1epaltrik/INFOBOT/robot.png

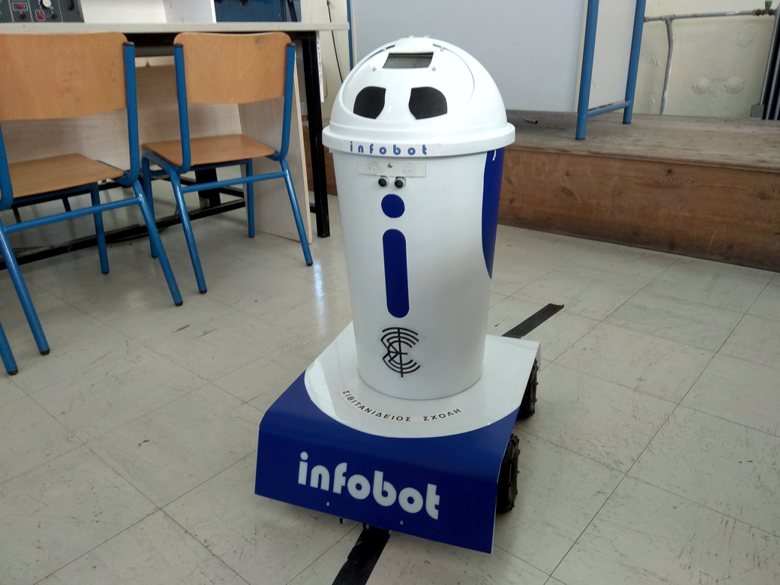
robot.png
