1epaltrik/INFOBOT/Kefalaio_8/ΚΕΦΑΛΑΙΟ_8_ΚΑΤΑΣΚΕΥΗ ΚΑΙ ΚΑΛΩΔΙΩΣΗ ΕΠΑΝΩ ΜΕΡΟΥΣ.docx

ΚΕΦΑΛΑΙΟ 8ο - ΚΑΤΑΣΚΕΥΗ ΕΠΑΝΩ ΜΕΡΟΥΣ

Υλικά:

Α/Α | Περιγραφή | Ποσότητα
1 | 3.5inch_TFT_Touch_Shield | 1
2 | MP3 Player BY-8001-16P | 1
3 | Arduino Atmega | 1
4 | DHT22/AM2302 Digital Temperature And Humidity Sensor | 1
5 | DS3231 Real Time Clock Module | 1
6 | Ηχεία (2 τεμ) | 1
7 | Ultrasonic sensor for arduino | 1

Άνοιγμα οπών για τοποθέτηση των πλακετών.

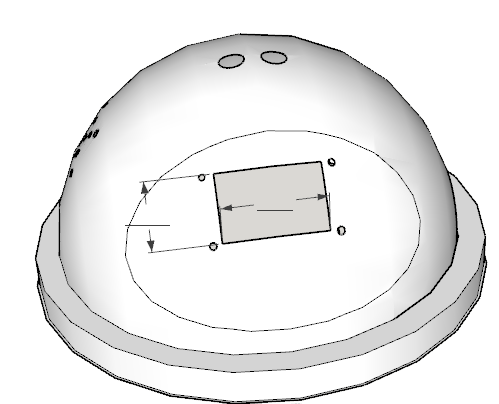
[picture p2: figure]
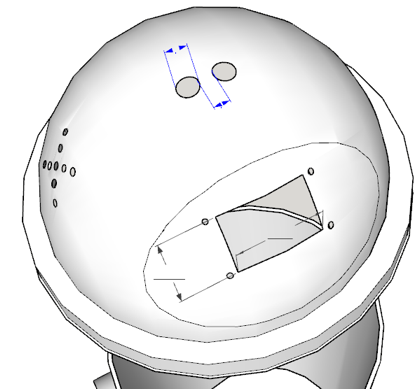
[picture p3: figure]
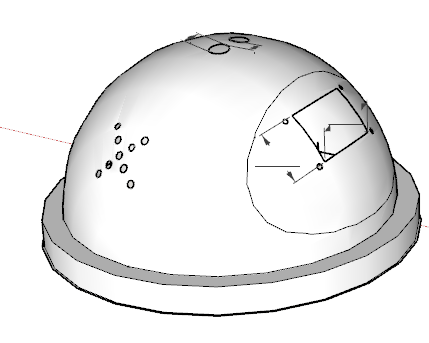
[picture p4: figure]
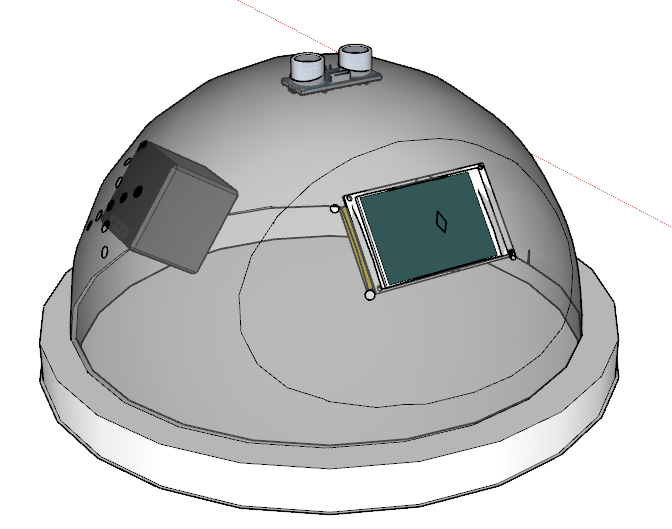
[picture p5: figure]

ΚΑΛΩΔΙΩΣΗ ΕΠΑΝΩ ΜΕΡΟΥΣ

Ακροδέκτες πλακετών.

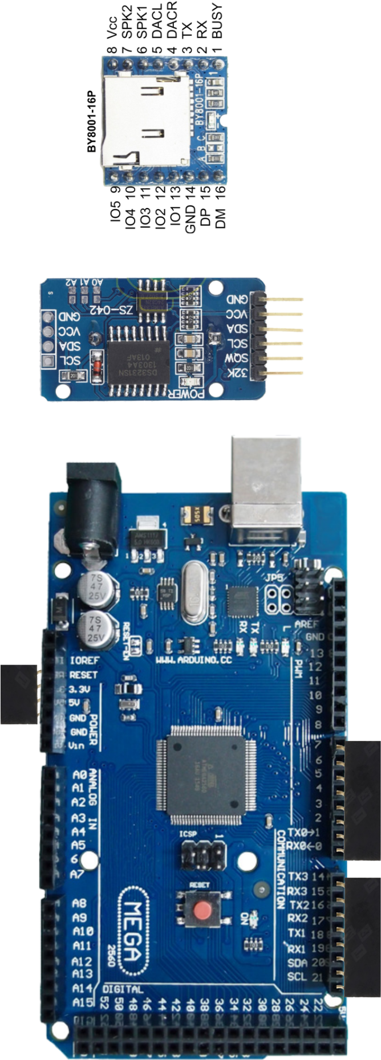
[picture p6: figure]
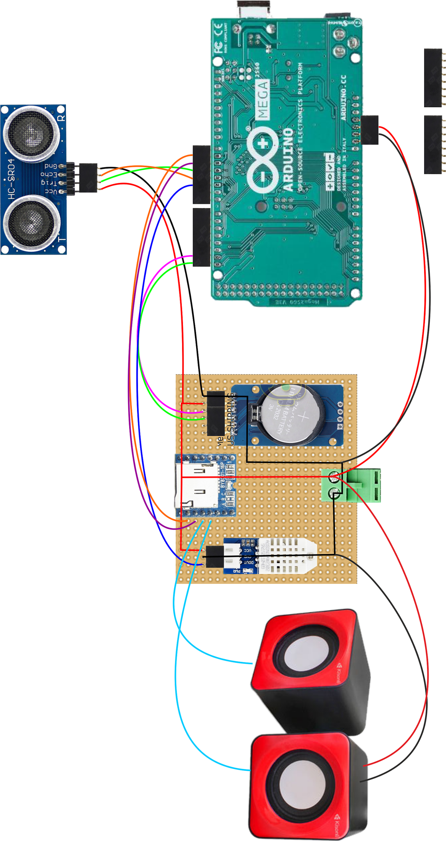
[picture p7: figure]
