1epaltrik/INFOBOT/Kefalaio_7/7ο ΚΕΦΑΛΑΙΟ_ΚΑΛΩΔΙΩΣΕΙΣ ARDUINO.docx

ΚΕΦΑΛΑΙΟ 7ο - ΚΑΛΩΔΙΩΣΕΙΣ ΣΤΟ ARDUINO

Καλωδίωση IR Module στο Arduino

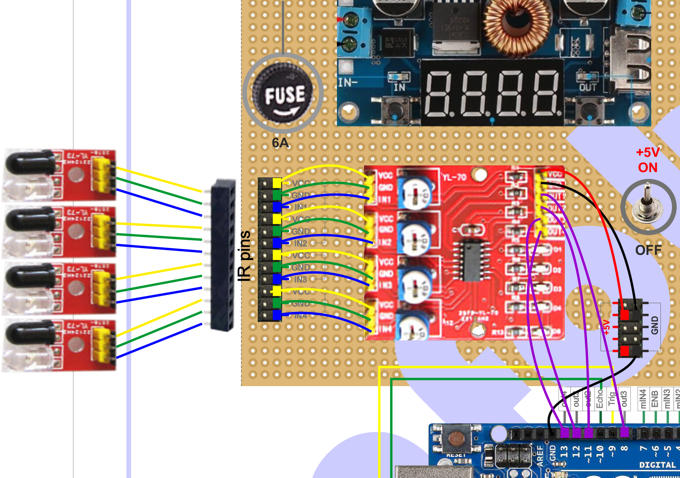
[picture p8: figure]

Καλωδίωση RGB driver Module στο Arduino

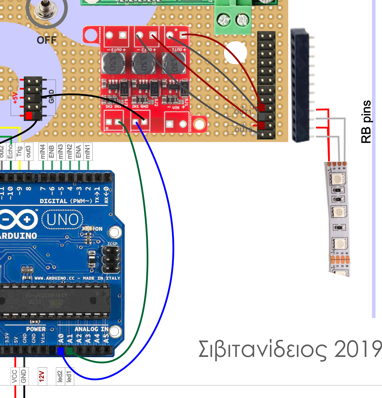
[picture p9: figure]

Καλωδίωση Motor driver Module στο Arduino

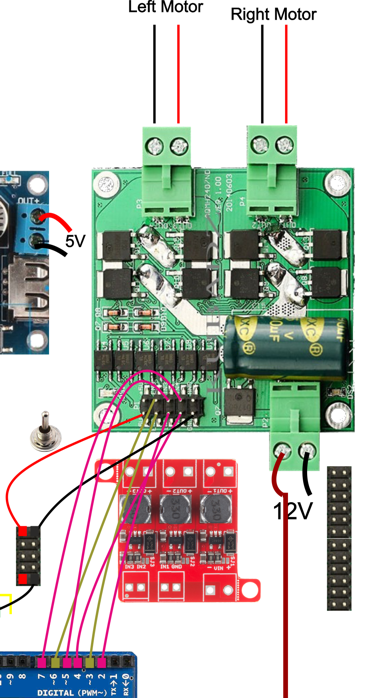
[picture p10: figure]

Σύνδεση UltraSonic και τροφοδοσία στο Arduino

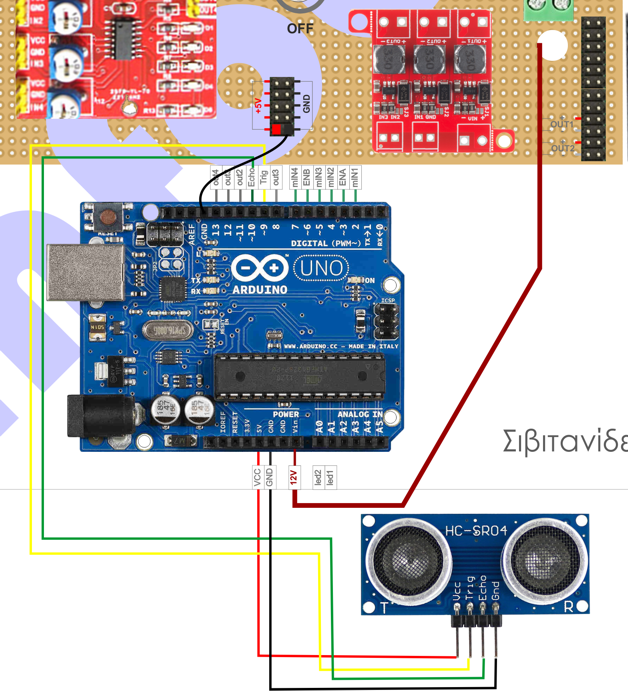
[picture p11: figure]
