1epaltrik/INFOBOT/Kefalaio_5/ΚΕΦΑΛΑΙΟ_5ο_ΟΠΕΣ ΚΑΙ ΚΑΛΩΔΙΩΣΗ ΤΡΟΦΟΔΟΣΙΑΣ.docx

ΚΕΦΑΛΑΙΟ 5ο - ΟΠΕΣ ΠΙΣΩ ΜΕΡΟΥΣ ΚΑΔΟΥ.

Υλικά:

Α/Α | Περιγραφή | Ποσότητα
1 | Επαναφορτιζόμενη μπαταρια μολυβδου 12V 7Ah | 1
2 | Φορτιστης μπαταριων μολυβδου 6-12V | 1
3 | Plug Jack 6,3 Male stereo | 1
4 | Socket, Jack 6,35mm, female, stereo, straight, panel mounting | 1
5 | Διακόπτης ON-OFF 220V | 1

Άνοιγμα οπών για τοποθέτηση θηλυκού βύσματος/διακόπτη φόρτισης μπαταρίας και διακόπτη λειτουργίας, στην πίσω πλευρά του κάδου.

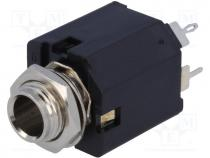
[picture p12: figure]
Socket, Jack 6,35mm, female, stereo, with on/off switch, straight
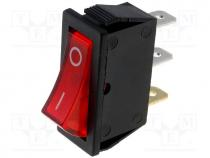
[picture p13: figure]
ROCKER, 2-position, SPST, ON-OFF, 15A/250VAC, red, neon lamp, 35mΩ
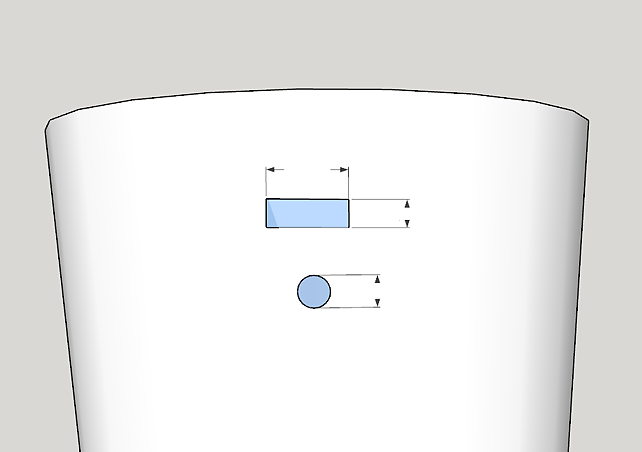
[picture p14: figure]
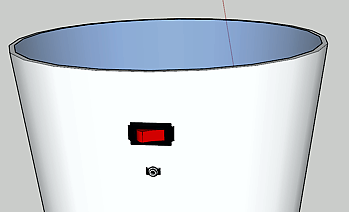
[picture p15: figure]

ΟΠΕΣ ΕΜΠΡΟΣ ΜΕΡΟΥΣ ΚΑΔΟΥ.

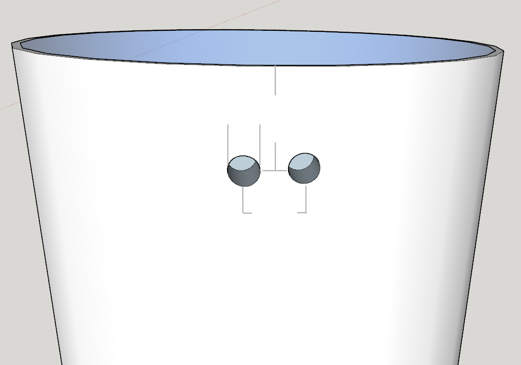
[picture p16: figure]

Τοποθέτηση UltaraSonic HC-SR04

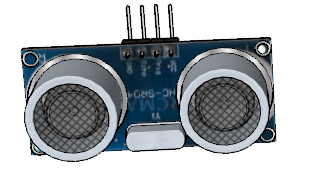
[picture p17: figure]
ultson

ΚΑΛΩΔΙΩΣΗ ΚΥΡΙΑΣ ΤΡΟΦΟΔΟΣΙΑΣ

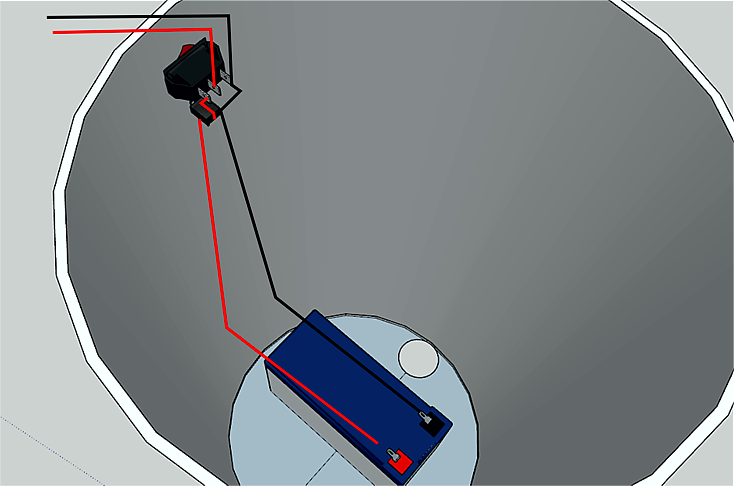
[picture p18: figure]
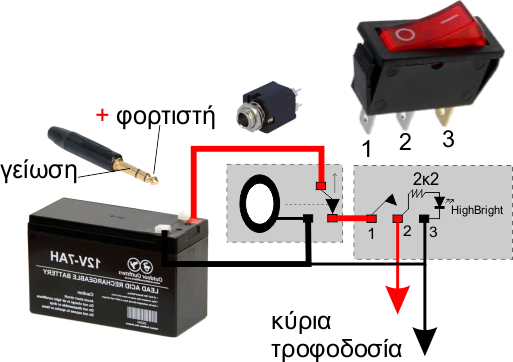
[picture p19: figure]
