1epaltrik/INFOBOT/Kefalaio_6/ΚΕΦΑΛΑΙΟ_6ο_ΚΕΝΤΡΙΚΗ ΠΛΑΚΕΤΑ.docx

6 - ΚΕΝΤΡΙΚΗ ΠΛΑΚΕΤΑ

Υλικά:

Α/Α | Περιγραφή | Ποσότητα
1 | 2x7A DC Motor Driver | 1
2 | 4 IR sensor | 1
3 | Arduino Uno + Shield | 1
4 | LED Driver | 1
5 | Adjustable 5A DC-DC Power Step-down Charge Module | 1
6 | Led strip 5050 | 1m

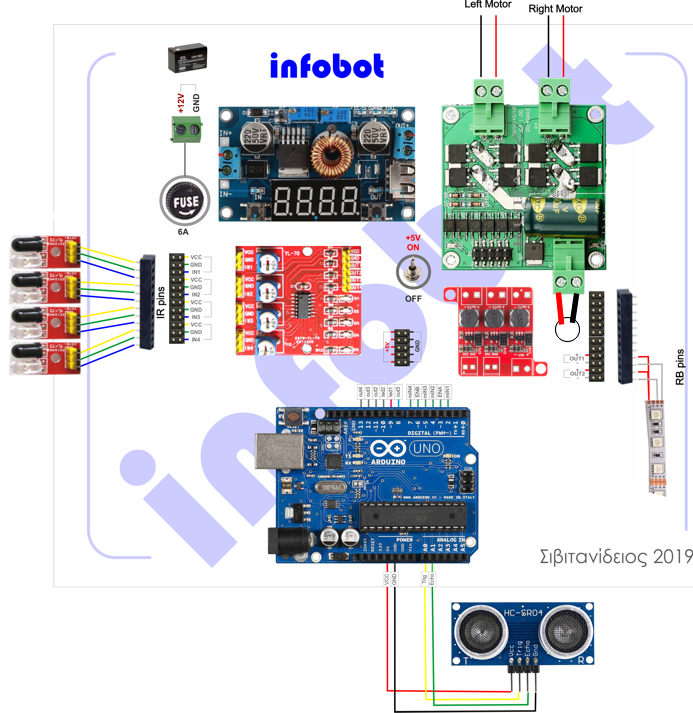
[picture p20: figure]

Πίσω όψη πλακέτας

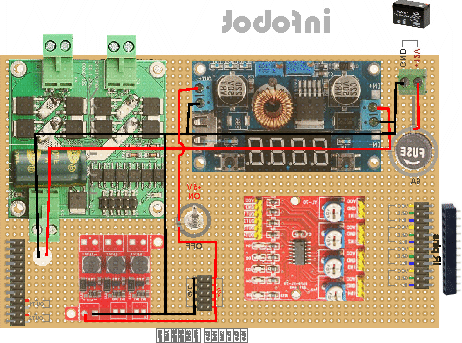
[picture p21: figure]

11 - ΤΟΠΟΘΕΤΗΣΗ ΤΩΝ RGB LED STRIP

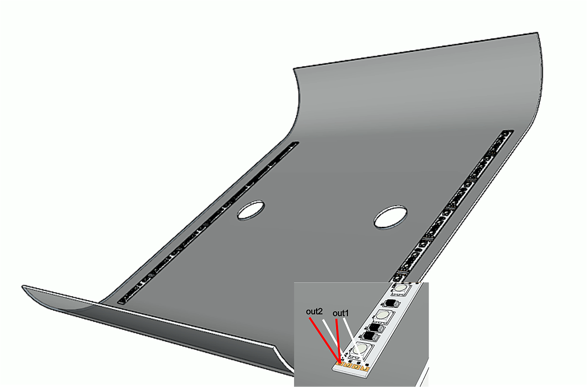
[picture p22: figure]
