1epaltrik/INFOBOT/Kefalaio_3/ΚΕΦΑΛΑΙΟ_3ο_ΒΑΣΗ.docx

ΚΕΦΑΛΑΙΟ 3ο - ΒΑΣΗ

Υλικά:

Α/Α | Περιγραφή | Ποσότητα
1 | Βάση από Plexiglass ή PVC (70x45cm) | 1
2 | Κάδος Αποριμμάτων (60x30x25cm) | 1
3 | Βάση για IR sensors από plexiglass (18x4cm) | 1

PVC ή Plexiglass

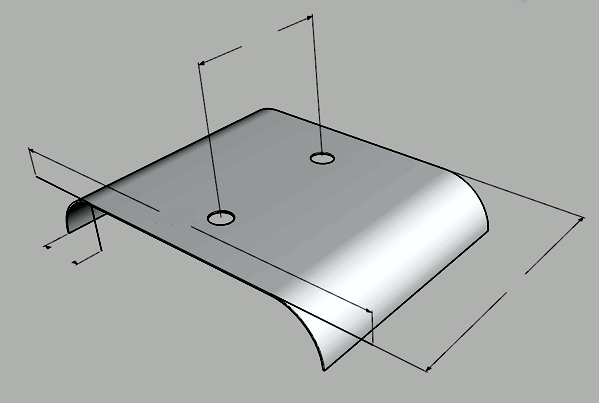
[picture p23: figure]
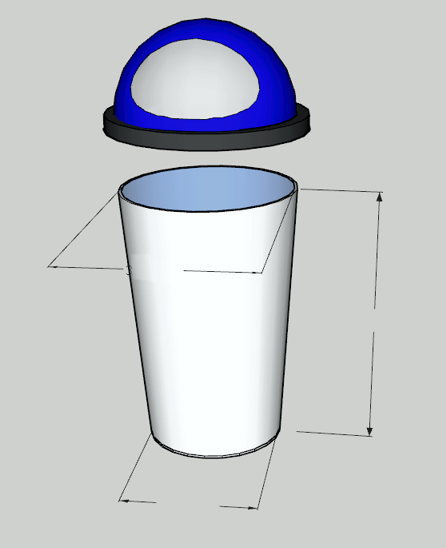
[picture p24: figure]

Κάδος πλαστικός με οπές ώστε να εφαρμόζει ο κάθετος σωλήνας του σκελετού

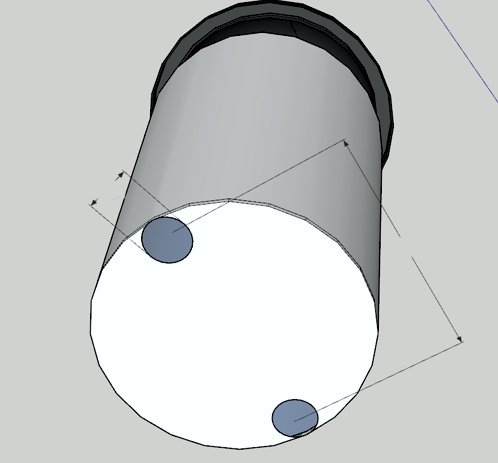
[picture p25: figure]

ΒΑΣΗ ΣΤΗΡΙΞΗΣ IR SENSORS.

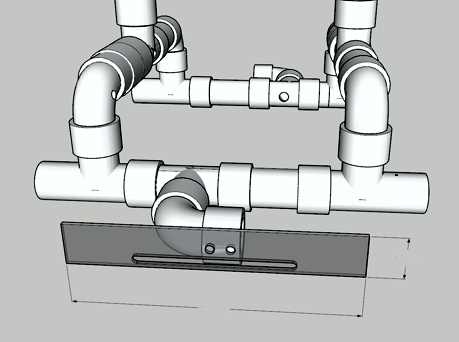
[picture p26: figure]

ΔΗΜΙΟΥΡΓΙΑ ΟΠΩΝ ΚΑΛΩΔΙΩΣΗΣ.

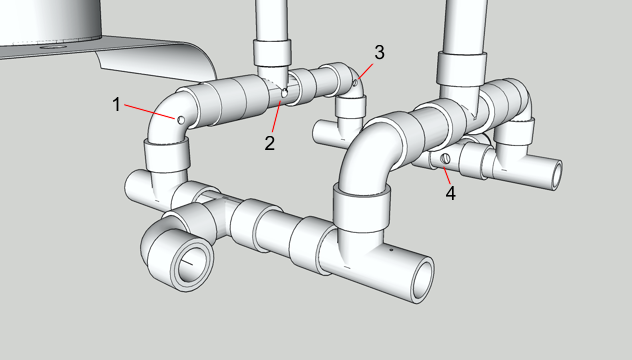
[picture p27: figure]

Χ 2 ΠΛΕΥΡΕΣ

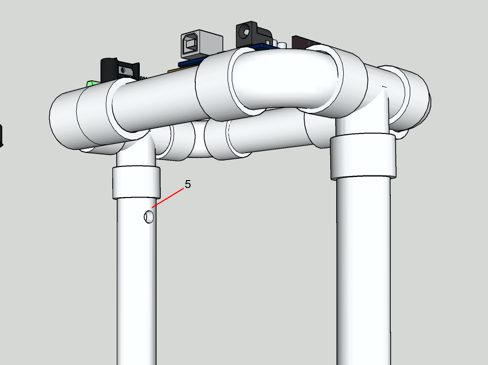
[picture p28: figure]

Χ 2 ΠΛΕΥΡΕΣ
