1epaltrik/INFOBOT/Kefalaio_4/ΚΕΦΑΛΑΙΟ_4ο_ΚΑΛΩΔΙΩΣΗ ΚΑΤΩ ΜΕΡΟΥΣ.docx

ΚΕΦΑΛΑΙΟ 4ο - ΚΑΛΩΔΙΩΣΗ ΚΑΤΩ ΜΕΡΟΥΣ

Υλικά:

Α/Α | Περιγραφή | Ποσότητα
1 | Καλώδιο πολύκλωνο 10 χρώματα
2 | Ακιδοσειρά male | 50 pins
3 | Terminal block | 2

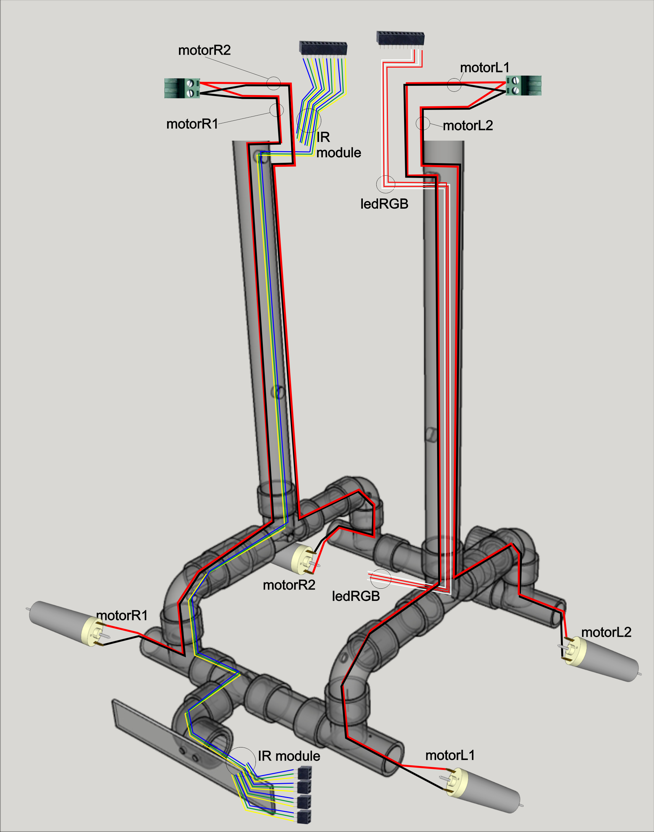
[picture p33: figure]
