1epaltrik/INFOBOT/Kefalaio_2/ΚΕΦΑΛΑΙΟ_2ο_ΣΚΕΛΕΤΟΣ.docx

ΚΕΦΑΛΑΙΟ 2ο - ΣΚΕΛΕΤΟΣ

Υλικά:

Σωλήνες υλικό κατασκευής:

ΤΑΦ διάμετρος Φ: 30 | Γωνία 90ο διάμετρος Φ: 30 | Ευθεία σωλήνα διάμετρος Φ:30 | Μούφα διάμετρος Φ: 30
ποσότητα: | ποσότητα: | ποσότητα: | ποσότητα:

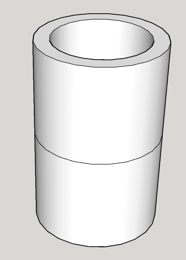
[picture p34: figure]
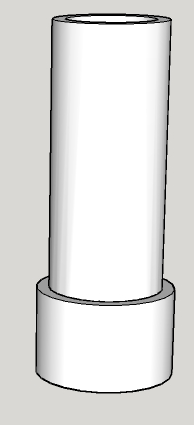
[picture p35: figure]
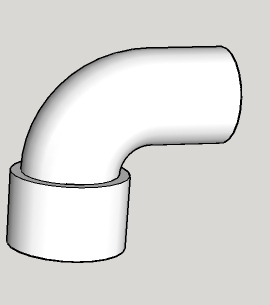
[picture p36: figure]
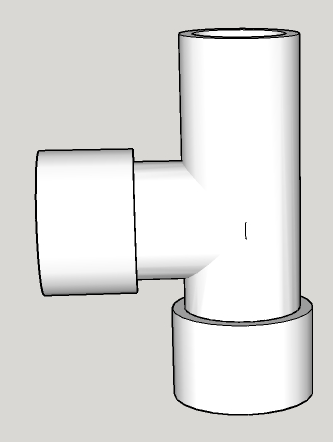
[picture p37: figure]

Συναρμολόγηση σκελετού:

Βήμα 1:

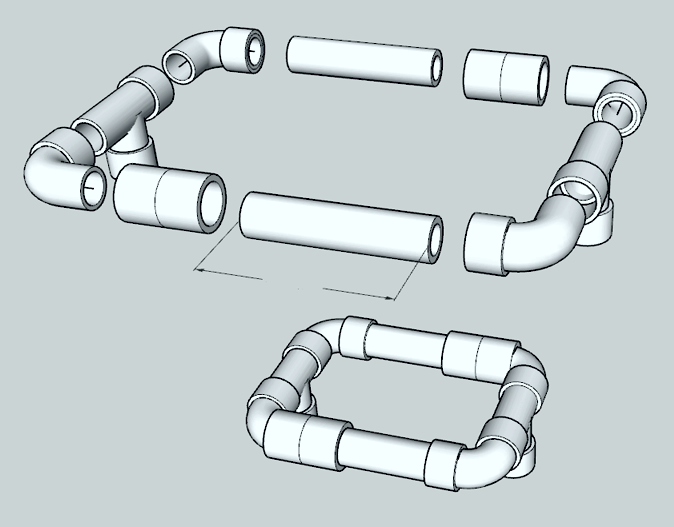
[picture p38: figure]

Βήμα 2Χ2:

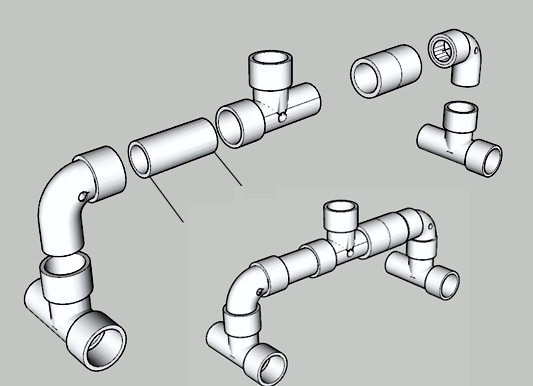
[picture p39: figure]

Βήμα 3Χ2:

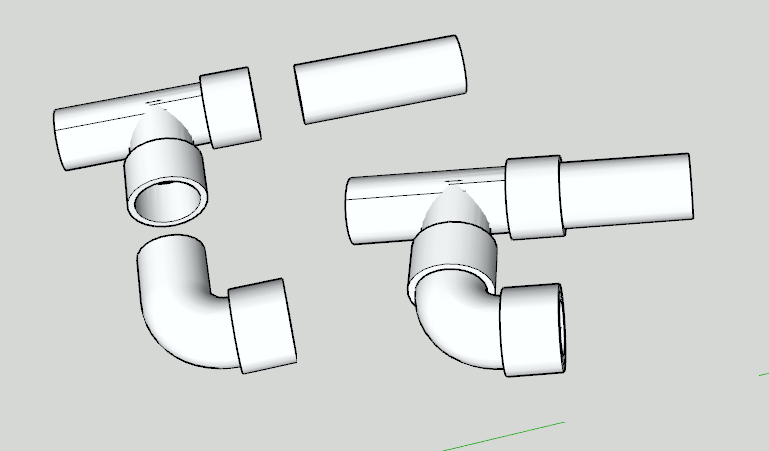
[picture p40: figure]

Βήμα 4:

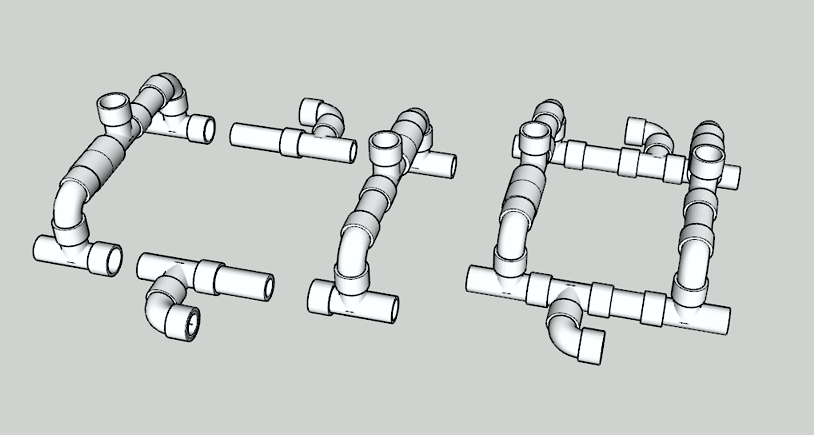
[picture p41: figure]

Βήμα 5:

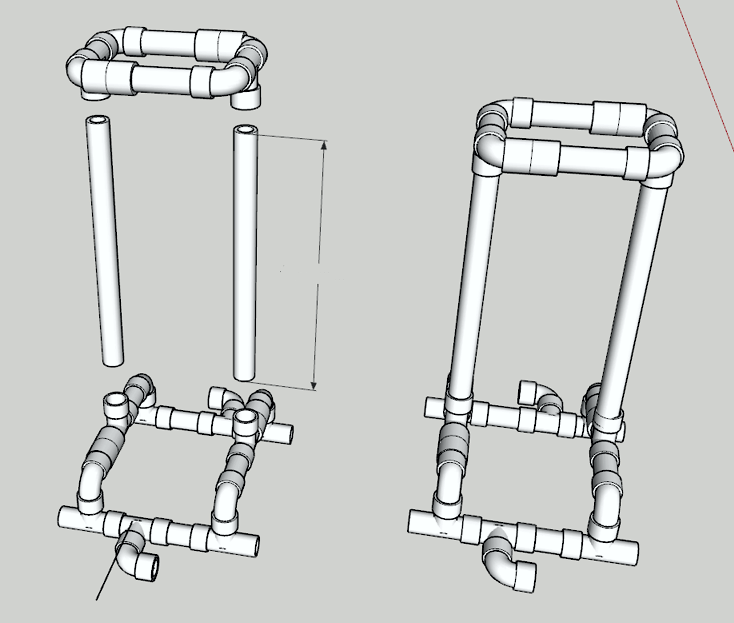
[picture p42: figure]

Βήμα 6:

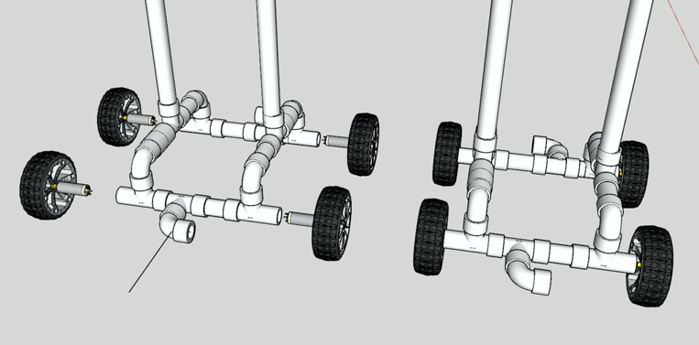
[picture p43: figure]

Χαρακτηριστικά σκελετού:

Βάρος σκελετού:
