1epaltrik/INFOBOT/Kefalaio_10/TFT_MP3/Calibri24x32GR.c

// Calibri24x32GR.c
// Font type    : Full (95 characters)
// Font size    : 24x48 pixels
// Memory usage : 13684 bytes

#if defined(__AVR__)
    #include <avr/pgmspace.h>
    #define fontdatatype const uint8_t
#elif defined(__PIC32MX__)
    #define PROGMEM
    #define fontdatatype const unsigned char
#elif defined(__arm__)
    #define PROGMEM
    #define fontdatatype const unsigned char
#endif

fontdatatype Calibri24x32GR[13684] PROGMEM={
0x18,0x30,0x20,0x5F,
0x00,0x00,0x00,0x00,0x00,0x00,0x00,0x00,0x00,0x00,0x00,0x00,0x00,0x00,0x00,0x00,0x00,0x00,0x00,0x00,0x00,0x00,0x00,0x00,0x00,0x00,0x00,0x00,0x00,0x00,0x00,0x00,0x00,0x00,0x00,0x00,0x00,0x00,0x00,0x00,0x00,0x00,0x00,0x00,0x00,0x00,0x00,0x00,0x00,0x00,0x00,0x00,0x00,0x00,0x00,0x00,0x00,0x00,0x00,0x00,0x00,0x00,0x00,0x00,0x00,0x00,0x00,0x00,0x00,0x00,0x00,0x00,0x00,0x00,0x00,0x00,0x00,0x00,0x00,0x00,0x00,0x00,0x00,0x00,0x00,0x00,0x00,0x00,0x00,0x00,0x00,0x00,0x00,0x00,0x00,0x00,0x00,0x00,0x00,0x00,0x00,0x00,0x00,0x00,0x00,0x00,0x00,0x00,0x00,0x00,0x00,0x00,0x00,0x00,0x00,0x00,0x00,0x00,0x00,0x00,0x00,0x00,0x00,0x00,0x00,0x00,0x00,0x00,0x00,0x00,0x00,0x00,0x00,0x00,0x00,0x00,0x00,0x00,0x00,0x00,0x00,0x00,0x00,0x00,  // <space>
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
};
